Jamie215/splint_adherence/(commit log)

2025-03-07 Initial set of fixes
    [arduino.py]
2025-03-11 Fixed the dependency on serial when configured, modified serial communication pathway between interface and arduino
    [arduino.py]
2025-03-12 Minor fix with download_data
    [arduino.py]
2025-03-26 WDT based 5 min wakeup code; consumes 1.1mA
2025-03-27 Using delay() approach; this code should achieve <1 mA current draw while sleeping
2025-04-01 Modified code back to arduino syntax for repetitive collection; resting current consumption <750 microAmps
2025-07-31 Reduce the sleeping current to be under 300 microamps
2025-07-31 Re-enabling some of the necessary features for serial communication whe the mode switches from loggig back to idle
2025-09-23 Code clean up & new script for arduino to incorporate colour reader sensor (APDS)
2026-01-06 Updating Arduino script to remove unnecessary delays and correct the variable type for proximity value; analysis view has been updated to better process the collected data
    [arduino.py, collect_temperature.ino]
2026-08-21 Fix modal/shutdown bugs and refactor analysis figure building
    Bug fixes:
    - index_page: initialize validation used `all([...])`, which rejected
    legitimate zero values (midnight hour, minute 0, personal ID 0). Check
    explicitly for None instead.
    - app: fix malformed `<<h1>` in the timeout page markup.
    - app: remove the dead `shutdown()` helper that POSTed to a nonexistent
    `/shutdown` route, and simplify `shutdown_server()` to `os._exit(0)`
    (the werkzeug/psutil path could never run under gevent/SocketIO from a
    background thread). Drop now-unused psutil and requests imports.
    Robustness:
    - data_analysis: read stored JSON via io.StringIO (pandas 2.x deprecates
    passing a raw string), an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
    [app.py]
2026-08-21 Refactor arduino serial access into an ArduinoClient class
    Replace the module-global `arduino_serial` and the connect-if-not-connected
    boilerplate that was duplicated across get_device_status/initialize_arduino/
    download_file with an ArduinoClient class that owns the connection state and
    centralizes reconnection in a single `_ensure_connected` helper.
    - Connection state lives on the instance, so the client can be tested in
    isolation by injecting a fake serial object (no global to reset between
    tests).
    - `download` restores the original timeout in a finally block and no longer
    leaves a stray debug print in the read loop.
    - A shared `arduino.client` singleton preserves a single connecti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
    [app.py, arduino.py]
2026-08-21 Project hygiene: logging, requirements, README, assets path
    - Route all print() calls through the logging module. app.py now calls
    logging.basicConfig() at startup (previously the logging.info calls in the
    heartbeat/shutdown code emitted nothing); arduino.py and index_page.py get
    module loggers with appropriate levels (info/warning/error, and
    logger.exception for the modal error handler).
    - requirements.txt: re-save as UTF-8 (was UTF-16) and reduce from a full
    pip freeze to the direct dependencies only, letting pip resolve transitive
    ones. Dropped psutil and requests, which are no longer imported.
    - app_instance.py: resolve the assets folder relative to __file__ instead of
    os.g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
    [app.py, app_instance.py, arduino.py]
2026-08-21 Deep-sleep power path and proximity-drift mitigation for logger
    Power: replace the busy delay() interval wait with true nRF52840
    System-ON deep sleep driven by the on-chip RTC2 at 1 Hz. Interrupts
    are masked during sleep (with SEVONPEND for RTC wakeup) to eliminate
    the ~1 kHz RTOS-tick wakeups that pinned sleep current near 300 uA.
    Elapsed-time tracking moves from millis() onto the free-running RTC2
    counter so timestamps stay accurate across sleeps.
    Proximity drift: program the APDS9960 explicitly each cycle over I2C
    (lower IR LED drive to cut self-heating, fixed gain/pulse count,
    explicit offset registers) and discard warm-up samples so every
    reading is taken under identical, settled condi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
    [collect_temperature.ino]
2026-08-24 Decide logger mode from USB presence instead of a persisted toggle
    The boot-time mode decision inferred intent from a persisted flag plus
    data-presence, which had no way to tell a battery power-up (should log)
    from a USB connection (user wants to interact). A just-initialized
    device (idle + no data) therefore booted into logging with USB
    disabled, so it disappeared from the host and could not be
    re-initialized or downloaded; and because a USB-CDC open does not reset
    the nRF52840, setup() often never re-ran on connect at all.
    Choose the mode from the on-chip VBUSDETECT instead:
    - On USB: always idle and interactive (init/status/download reachable);
    never auto-log or disable USB.
    - On batte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
    [collect_temperature.ino]
2026-08-24 Revert "Decide logger mode from USB presence instead of a persisted toggle"
    This reverts commit 7ca502cdfcc833286f0b6f9b72ad7b3985c5be5b.
    [collect_temperature.ino]
2026-08-24 Restore logger firmware to last-known-good (e8b23f9)
    Roll collect_temperature.ino back to the known-working state machine and
    logging loop. Both prior firmware experiments on this branch (RTC2
    deep-sleep timing and the USB-presence mode decision) are dropped; they
    interfered with entering data-collection mode. Power and proximity-drift
    work will be re-approached separately against this baseline.
    Claude-Session: https://claude.ai/code/session_01QR8KQHEdwqNzJb7t2ocaZo
    [collect_temperature.ino]
2026-08-24 Proximity drift mitigation: explicit APDS9960 config + warm-up discard
    Program the APDS9960 proximity engine to a fixed, known configuration
    (gain, pulse count, offset registers) on every sample instead of relying
    on whatever the library last left it in, and discard a few warm-up
    samples so each reading is taken from a settled front end. This reduces
    the long-term baseline drift without touching timing, sleep, or the
    state machine. IR LED drive is kept at full so proximity magnitudes
    match the previous firmware; the CONTROL/PPULSE values are single
    tunable constants.
    Claude-Session: https://claude.ai/code/session_01QR8KQHEdwqNzJb7t2oca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
    [collect_temperature.ino]
2026-08-24 Diagnostic build: observable logging + SPI/I2C fix under test
    Built on the clean e8b23f9 baseline (drift change set aside for now).
    - FIX UNDER TEST: stop disabling NRF_SPI0/SPI1 in the logging power-down.
    On the nRF52840 those share silicon with the TWI0/TWI1 (I2C) controllers
    the APDS9960/HS300x use, so disabling them can kill I2C in logging mode
    and hang the proximity read -- which explains no data being logged,
    LED_PWR staying lit, and the resulting boot-mode toggling.
    - DEBUG_LOGGING switch (currently 1): keeps USB/serial alive during
    logging and prints each cycle (APDS.begin, HS300x.begin, proxReady,
    proximity, temperature) so the failure is observable over serial.
    - Repla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
    [collect_temperature.ino]
2026-08-24 Fix logging hang: stop disabling I2C-shared SPI peripherals
    Confirmed on hardware (APDS.begin=1, proxReady=1, prox=238, temp=29.03):
    disabling NRF_SPI0/SPI1 in the logging power-down was killing the
    TWI0/TWI1 (I2C) controllers the APDS9960/HS300x share silicon with, so
    the proximity read hung, no data was logged, LED_PWR stayed lit, and the
    boot state machine toggled endlessly.
    - Keep SPI0/SPI1 enabled (commented out) so I2C survives in logging mode.
    - Replace the infinite proximity busy-wait with a 1 s bounded wait so a
    stuck/absent sensor can never freeze the logger again.
    - DEBUG_LOGGING switch (default 0) left in place for future bench
    debugging: at 1 it keeps serial alive during lo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
    [collect_temperature.ino]
2026-08-24 Proximity: discard warm-up samples for a settled reading
    Take the logged proximity value after discarding a couple of warm-up
    conversions, so it reflects a settled sensor front end rather than the
    first reading right after the per-cycle APDS power-on. Each conversion
    wait stays bounded, so a stuck/absent sensor still can't hang logging.
    Sensor gain/LED-drive are intentionally left at the library default
    (APDS re-initializes on every begin()), so the proximity scale is
    unchanged and existing analysis thresholds still apply. This targets
    per-sample settling, not the thermal component of long-term drift, which
    is best addressed by relative/baseline detection in analysis.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
    [collect_temperature.ino]
2026-08-25 Low-power sleep between samples via RTC2 + __WFI
    Replace delay() between samples (which leaves the chip in a shallow
    ~584uA sleep) with a true low-power System-ON sleep: RTC2 at 1024 Hz
    wakes the CPU from __WFI at the deadline. Interrupts stay enabled, so
    millis(), the RTOS, timing, and the state machine are all unchanged --
    only the CPU idles deeper. Deploy path only; DEBUG_LOGGING keeps delay()
    so serial stays responsive for bench debugging.
    RTC2 is free (RTC0 = SoftDevice, RTC1 = mbed tick). HFCLK is already
    stopped on entering logging. First step of a measure-driven pass; if a
    large residual remains it is most likely the I2C/TWI peripheral left
    enabled for the bus fix, addressed next by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
    [collect_temperature.ino]
2026-08-25 Revert "Low-power sleep between samples via RTC2 + __WFI"
    This reverts commit b0cdfce7210e6a214e69dba5d5eefd0f6d9ce975.
    [collect_temperature.ino]
2026-08-25 Consolidate to the three keeper firmware changes
    Net diff vs main is now exactly the changes worth keeping:
    - I2C fix: stop disabling SPI0/SPI1 in the logging power-down (they share
    silicon with the TWI0/TWI1 controllers the sensors use; disabling them
    hung every sample and logged nothing). Confirmed on hardware.
    - Bounded proximity wait: the infinite APDS.proximityAvailable() busy-wait
    can no longer freeze the logger if the sensor stalls.
    - Warm-up discard: read proximity after the front end settles, at the
    library-default gain, so the proximity scale is unchanged.
    Drops the temporary debug scaffold and the reverted low-power sleep
    experiments; both remain in history if ever needed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
    [collect_temperature.ino]
2026-08-25 Logger firmware: fix I2C-killing power-down, harden proximity read
    Three fixes to collect_temperature.ino, on top of the current logger
    firmware:
    - I2C bus fix: stop disabling SPI0/SPI1 in the logging-mode power-down.
    On the nRF52840 those share silicon with the TWI0/TWI1 (I2C)
    controllers the APDS9960 and HS300x sensors use, so disabling them
    killed the bus in logging mode -- the proximity read hung forever and
    no data was ever recorded. Confirmed on hardware.
    - Bounded proximity wait: replace the infinite
    while(!APDS.proximityAvailable()) busy-wait with a bounded wait, so a
    stalled or absent sensor can no longer freeze the logger.
    - Warm-up discard: take the logged proximity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
    [collect_temperature.ino]
2026-08-25 Add GitHub Actions workflow to build Windows and macOS releases
    Build the standalone Windows .exe and macOS .app bundle on version-tag
    pushes and attach both to a GitHub Release. Also name the macOS bundle
    explicitly in setup.py so bdist_mac produces a predictable output path.
    Claude-Session: https://claude.ai/code/session_011vdrJEhCBf46BaqUT7goRp
2026-08-25 Fix requirements.txt encoding (UTF-8) and add idna for cx_Freeze
    Two build failures fixed:
    - requirements.txt was still UTF-16 (inherited from the PowerShell
    pip-freeze); pip on macOS could not parse it. Rewrite as UTF-8.
    - setup.py includes idna.idnadata, but idna was not in the dependency
    set, so the Windows build failed with No module named idna.idnadata.
    Pin idna explicitly so cx_Freeze can bundle it.
    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
2026-08-25 Add manual dispatch and per-run artifacts to build workflow
    Allow the build to run via workflow_dispatch (a Run workflow button) so a
    branch can be tested without pushing a tag, and upload each bundle as a
    run artifact. Release publishing stays gated to tag pushes.
    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
2026-08-25 Fix crash on launch in windowed build: guard None stdout/stderr
    A Win32GUI (windowed) cx_Freeze build has no console, so sys.stdout and
    sys.stderr are None. numpy.f2py (pulled in transitively by scipy) writes
    to them at import time, crashing the frozen app with
    "'NoneType' object has no attribute 'write'" before the GUI can start.
    Redirect stdout/stderr to os.devnull when they are None, before importing
    the pages that import scipy.
    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
    [app.py]
2026-08-25 Fix assets/CSS not loading in frozen build
    In a cx_Freeze build this module lives under lib/ (or library.zip), so
    __file__ points there rather than next to the executable, and Dash could
    not find the assets/ folder that include_files places alongside the exe.
    Anchor the assets path on sys.executable when frozen so style.css and the
    other assets load in the packaged app.
    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
    [app_instance.py]
2026-09-02 Make proximity onset/offset gate invariant to sensor baseline drift
    The APDS9960 proximity reading carries a slowly-varying DC pedestal that
    climbs over a deployment as the battery discharges and the optical front
    end drifts. The detector's raw `prox == 0` test for "sensor covered"
    therefore decays over time: on a 35-day sample the quiescent floor walks
    from 0 into the ~50s, so past the first ~11 days nothing is ever exactly
    0 even while worn, and the proximity gate silently stops contributing.
    Add `dedrift_proximity`, which tracks the quiescent floor with a ~1-day
    rolling low percentile and derives a drift-invariant "covered" mask from
    the residual above that floor, thresholded against a r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
2026-09-28 Keep device config safe from interrupted saves; recover lost start times
    A reset or power loss between erasing and reprogramming the single config
    page left it blank (0xFFFFFFFF), so downloads showed a start time of
    2106-02-07 and data rows wrapped to 1970. The readings themselves survived.
    Firmware:
    - Store the config in two flash pages (A/B) with a magic, sequence number
    and CRC; each save writes the inactive page, so an interrupted save never
    destroys the last good copy.
    - With no valid config, stay idle and download with start time UNKNOWN and
    rows as raw elapsed seconds instead of garbage timestamps.
    - Don't write a default config when flash init fails.
    Interface:
    - Detect files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
    [collect_temperature.ino]
2026-09-28 Rebuild lost start times at device download; solid recovery buttons
    When a device download has no valid start time (blank settings from older
    firmware, or UNKNOWN from current firmware), the Download Data modal now
    asks for the start date/time before saving and writes the file with real
    timestamps. "Save Without Correcting" keeps the raw file, which can still be
    corrected later on the Data Analysis page.
    The Rebuild Timestamps and Download Corrected CSV buttons now use the app's
    solid steel-blue button style instead of Bootstrap primary / outline grey.
    Claude-Session: https://claude.ai/code/session_014RR8XccRRa4ZqmXhRgtzPB
2026-09-28 Show and accept times in Eastern (America/New_York), plus small fixes
    - Initialize: the entered start time is Eastern wall-clock time (DST-aware);
    the device still stores the equivalent UTC epoch.
    - Download: device epochs are written as Eastern ISO timestamps with their UTC
    offset, and a 'Timezone' metadata line is added.
    - Analysis: timestamps are converted to tz-aware Eastern. Legacy naive-UTC
    files are converted too. Durations and day splits are DST-correct, and plots
    get naive Eastern wall-clock times.
    - The time zone is defined once in timezone_config.py. pytz and tzdata are
    bundled in frozen builds.
    Small fixes:
    - Surface initialization failures in the UI instead of reporti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
    [arduino.py, collect_temperature.ino, timezone_config.py]
2026-09-28 Vendor fonts, Bootstrap theme and icons so the app works offline
    Replace the CDN stylesheets (Google Fonts Roboto, Bootswatch LITERA, Font
    Awesome) with local copies under assets/vendor/, at the same versions dbc
    pointed to. They are listed explicitly so they load before assets/style.css.
    Their .vendor.css suffix keeps Dash from auto-loading them a second time,
    since assets_ignore matches file names.
    Verified in headless Chromium with all non-local requests blocked: the page
    renders fully styled with zero external requests.
    Claude-Session: https://claude.ai/code/session_016Hrz2XTs5XgoNPFUY2AB5r
    [app_instance.py]
2026-09-28 Add pytest suite and CI test workflow
    Covers wear-event detection, drift invariance, cadence inference, midnight
    and DST day-splitting, empty summaries, CSV parsing (current, legacy,
    malformed), Eastern-time conversion, download formatting, and the init
    packet/checksum, using a fake serial port. No hardware is needed.
    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
2026-09-28 Add developer handoff doc and refresh README
    HANDOFF.md covers architecture, the device power-cycle lifecycle, firmware
    hardware lessons, the detection algorithm with a parameter table, time zone
    design, vendored assets, known limitations left unverified, the
    build/test/release runbook, and an access checklist.
    The README now links to it, documents tests, the macOS build and the tag-based
    release flow, and the Eastern-time CSV format.
    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
2026-09-28 Accept alphanumeric participant IDs (up to 15 chars)
    The Initialize form used a number box limited to 0-65535, although the
    device and init packet already carry a 15-character text ID. The form now
    takes letters, digits, '-' and '_' (e.g. SA-014).
    - The rule lives in arduino.validate_personal_id. The field is flagged
    inline as you type, and Initialize does nothing until the ID is valid.
    - ArduinoClient.initialize rejects invalid IDs instead of silently
    truncating them, and sends the ID as-is. Numeric IDs still work.
    - Shorten the hour labels to 'Hour (ET)' and state 'Eastern time (ET)'
    in the form intro, so the labels no longer wrap.
    - Tests cover validation and the packed ID; docs up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
    [arduino.py]
2026-09-28 Clean up the interface and outdated code for v1.3.0
    Interface
    - Download/Initialize modal: show the actual error message (every failure
    used to read "Arduino Connection Failed"), show "No device found" when
    Connect finds nothing (it previously did nothing), and report download
    failures instead of leaving the button stuck.
    - Remove duplicate re-attempt-btn ids and the text search on the modal's
    children used to tell Initialize from Download; a store holds the mode.
    - Data Analysis recovery panel uses the same date/hour/minute pickers as
    the download modal instead of a typed HH:MM field (pages/components.py).
    - Navbar gets Home / Data Analysis links; analysis page uses the app font,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
    [app.py]
2026-09-28 Clarify deployment length: clock rollover, not battery or storage
    The 52-day figure is storage capacity (15,000 readings at 5 min), not battery
    life, and it is not the practical limit. millis() wraps at about 49.7 days,
    and the logger's sleep check is not wrap-safe. From the code, the rollover
    should cause a burst of rapid readings (likely filling memory) or a multi-day
    gap.
    HANDOFF.md now merges these into one 'Deployment length' item with a table of
    the three limits (clock, storage, battery), the predicted rollover behaviour,
    the wrap-safe fix and how to bench-test it. It sets the planning guidance to
    about a month: the design target, with ~36 days the longest tested run.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
2026-09-29 Make analysis chart hover labels legible
    The shared hoverlabel set only a white font. In the combined chart's
    'x unified' hover mode the box takes its background from the transparent
    paper colour, so the text was white on white. Give hover labels an explicit
    white background with dark text, and stop truncating trace names.
    Claude-Session: https://claude.ai/code/session_018fSiMA23Q7n74m5jWC2Ync
2026-09-29 Round temperature hover values to 2 decimals
    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
2026-10-14 Add SOP and project handover documents for transition
    - docs/SOP_Build_and_Use.md: operator SOP (logger states, materials,
    build [TODO]s, software setup, initialize, deployment, download,
    analysis, data handling, troubleshooting, Python and release appendices)
    - docs/Project_Handover.md: state at transition, open issues, next steps,
    design decisions and rationale, testing status, directions to explore
    - docs/build_docs.sh + style_docx.py + reference.docx: regenerate the
    Word copies from the Markdown masters with pandoc
    - docs/images/: app screenshots (simulated data) and device-lifecycle figure
    - README: link the new documents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
2026-10-14 Revise handover from review; redraw Figure 1 as device states
    - Port Jamie's review edits (title, scope note, logger status, next
    steps, key terms, goals) into the Markdown master
    - Split §1: open items that need testing (storage bound, battery life,
    thresholds) vs. known limitations that follow from design decisions;
    explanations moved into §4.1, §4.4 and §5.1
    - Clock drift: expected negligible with the board's crystal; replace the
    drift test with a free end-of-deployment time check (also in the SOP)
    - Drop cx_Freeze from reader-facing text
    - Figure 1: larger text, boxes are device states, arrows are triggers;
    fix Initialize from state 4 going to state 2 (not 1). Source HTML k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
2026-10-15 adding stl file for 3d print case
2026-10-15 Handover round 3: merge limitations into design, split next steps
    - Port Jamie's review edits (US spelling, §3–§7 wording, removed §3.3)
    - Remove the §1.3 limitations table; limitations live in §4.1, §4.4
    and §5.1; renumber §1 and fix cross-references (incl. the SOP)
    - Key terms: add Serial (USB serial) with the four commands
    - §8 keeps only what has been tested; new §9 Next steps (unverified
    items plus firmware robustness, ground truth, battery monitoring);
    §10 Directions adds a custom PCB
    - MAD spelled out as the median absolute deviation, matching the code
    - Figure 1: clearer trigger labels, low power mode, GUI download
    - New Figure 2: one reading from flash to the down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
2026-10-15 Handover round 4: drop appendices, review for non-technical readers
    - Port Jamie's edits; appendices removed and all references updated
    - Add a plain-language Summary at the top of §1; fold "testing to date"
    into §1.1; remove duplicated bullets and the developer file table
    (HANDOFF.md covers it); Directions to explore becomes §8
    - Next-steps rows lead with why each item matters
    - Consistent terms ("data collection", "app"); Key terms add Deployment,
    Wear event, Ground truth and App (GUI)
    - State the short-wear caveat (<~10 min not counted) in §5.1
    - SOP Appendix C: how to collect ground truth and re-tune the detection
    parameters
    - HANDOFF.md §8: keep the proposed firmware change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
2026-10-15 SOP: fill in hardware details; handover purpose-check fixes
    SOP
    - Hardware from Jamie: Nano 33 BLE Sense Rev2, CR2450 on the 3.3 V pin
    with the rear jumper cut (cell must stay connected on USB), power-cycle
    by unplugging the cell, 3D-printed case (splint_adherece_case.stl)
    secured with a Chicago screw, skin-friendly tape renewed per
    deployment, new cell per deployment
    - Flashing: bridge the jumper, flash, re-cut it
    - Checklist, deployment, download, cleaning and troubleshooting updated;
    "data collection" wording; remaining TODOs only for protocol and data
    governance items
    Handover
    - Port Jamie's Summary edit (loggers record, app estimates) and the
    removed USB-presence item; fi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
2026-10-15 SOP: port Jamie's §1–§6 rewrite with build photos; review fixes
    - Port the new "Building the device" section (materials/tools table,
    power wiring and case steps) with Jamie's photos, cropped as in Word
    (docs/images/sop/)
    - Safety: remove the coin cell before connecting USB while the 3.3 V
    jumper is intact or bridged (back-feed into a non-rechargeable cell)
    - Make §2.2 a test fit so the case is closed at deployment (§6); move
    the upload-failure note before the trace cut; drop the checklist clause
    for a removed step; GND wire may be black or blue; small wording fixes
    - Renumber cross-references (§2–§11) and figures (1–17) after the
    restructure; caption each figure once;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
2026-10-15 SOP: tighten §1.1; name the micro-USB data cable in §4
    Claude-Session: https://claude.ai/code/session_01Ue3sWJSFRo3Bxhe8SfexR3
2026-10-16 SOP: port Jamie's review edits; add clock-drift bench test appendix
    - Port Jamie's edits: EVA foam (materials + §2.2 note), shorter §6
    deployment note, download figures after step 4, CSV inspection option,
    end-time comparison removed from §7.1, US spelling, §9 data-governance
    wording, troubleshooting power-cycle hint, Appendix C trims
    - Light polish: tilted-sensor note, "press the reset button once",
    "case" instead of "wearable", "rules that use", subtitle spelling
    - New Appendix D: one-off bench test for clock drift (known start and
    stop times, 2–4 weeks, optional 60 s interval for finer resolution)
    - Handover next step 6 now points to the bench test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
2026-10-16 Docs review: daily-average warning, moulding, cost, consistency fixes
    - Warn that "Average Wear Time Per Day" excludes days with no detected
    wear (overstates adherence) and counts partial first/last days; give
    the workaround (Total Wear Time / days). Handover: Summary, new §5.5,
    next step 7 to fix it in the app. SOP: callout in §8
    - PI (orthopedist) moulds the case into each splint (handover §3.2,
    SOP §6); rough ~$60/logger cost estimate in handover §2
    - Remove the reference-sensor option; study protocol (wear instructions,
    skin checks) added to the ethics next step
    - Fix stale SOP references (§3.2, §9), "Download window", firmware
    version in the deployment log, wording of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
2026-10-16 Final pass on handover and SOP
    - Port Jamie's SOP edits (safety callout, "check the connection")
    - Handover: ethics and data-governance next steps no longer point to
    the SOP, since no plans exist yet
    - Average wear time framed as a definition choice, not an error
    (handover Summary, §5.5, next step 7; SOP §8 callout)
    - Remove the §1.1 start-time bullet that repeated the §5 callout
    - Light language fixes (handover About, §1.1, §4.4, §5.4; SOP §6);
    all cross-references re-checked
    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
2026-10-19 Handover: battery test before firmware fixes; rewrite design sections as prose
    Reorder next steps so battery life is measured first (it sets the urgency of
    the firmware fixes), keep Jamie's edits, rewrite §3-§7 in the SOP's readable
    style, and update item cross-references.
    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
2026-10-19 Handover: treat start time as a setup step, not a bug; trim document end
    Drop start time from the firmware-fix next step and HANDOFF.md known
    issues; keep a reminder to set the start time to when the battery is
    connected. Port Jamie's 'jumper trace' edit, shorten the last table row so
    the document fits on 9 pages, and end the docx with a 1-pt paragraph so Word
    does not add a blank page after the final table.
    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
2026-10-19 Docs: final wording polish before submission
    Fix the battery-estimate wording, define-free PLA note (drop MSK-IF),
    clearer key-term and resting-current phrasing, and matching version lines.
    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
2026-10-19 README: align with the SOP and Project Handover
    Rev2 board, coin cell and cut 3.3 V jumper, flashing with the jumper bridged,
    release builds for staff, power-cycle before download, Eastern timestamps in
    the CSV (not UTC), start time = battery connection, one-month deployments,
    daily-average definition, and a current example ID and release tag.
    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
